vinayshanbhag/10Hz-100KHz-LNA/README.md

# 10Hz-100KHz-LNA
Low noise amplifier for ripple and noise measurements (10Hz-100Khz)
based on <a href="https://github.com/vinayshanbhag/10Hz-100KHz-LNA/blob/main/an-83.pdf">AN-83</a>

### Schematic


### Impulse response (spice model)
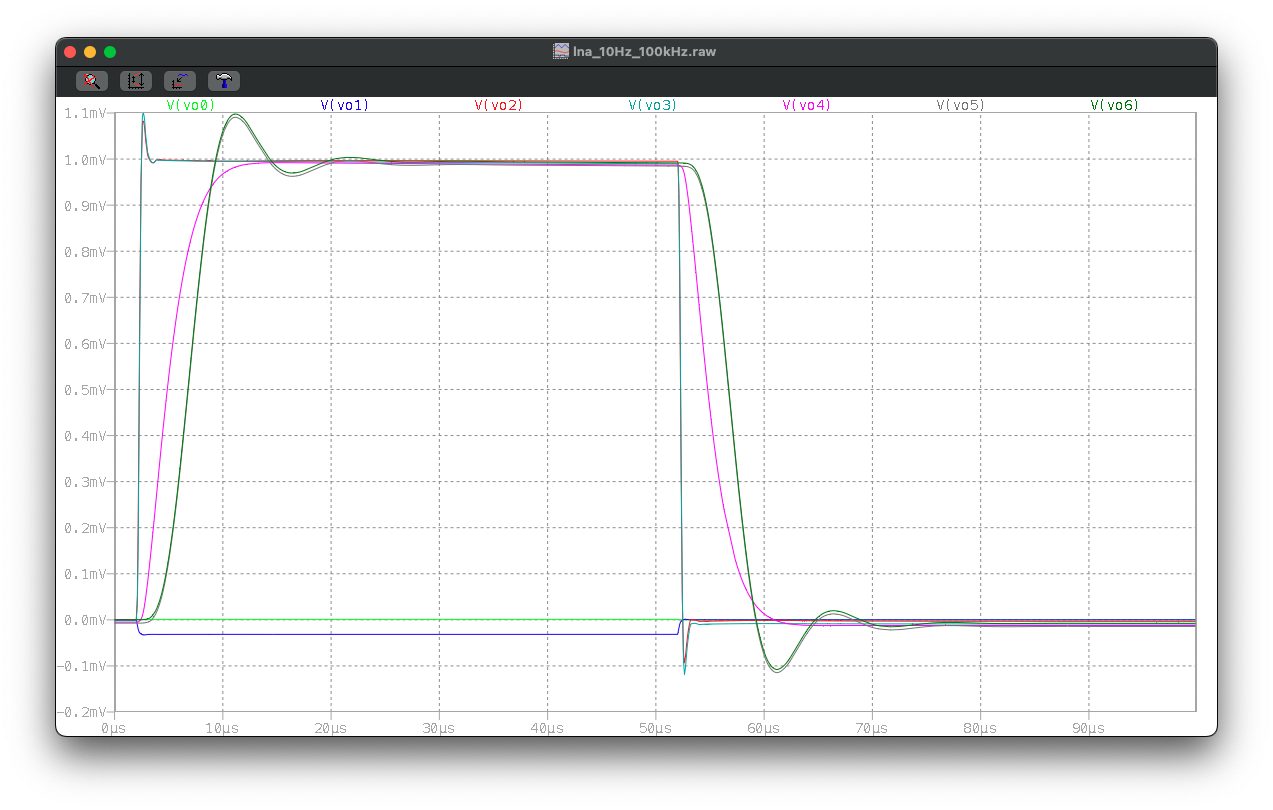
[picture p1: impulse-response-spice.png]


### Frequency response (spice model)
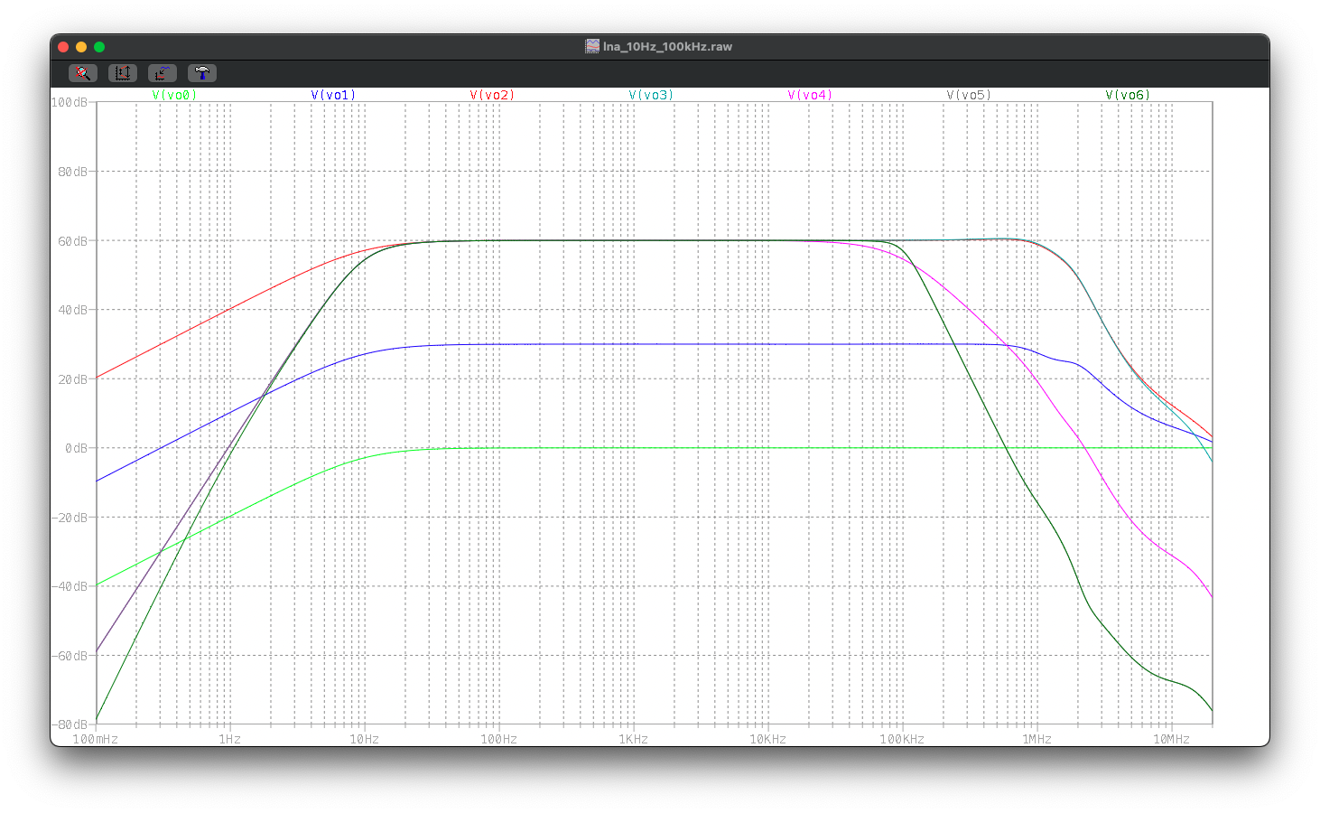
[picture p2: freq-response-spice.png]


### Frequency response (measured)
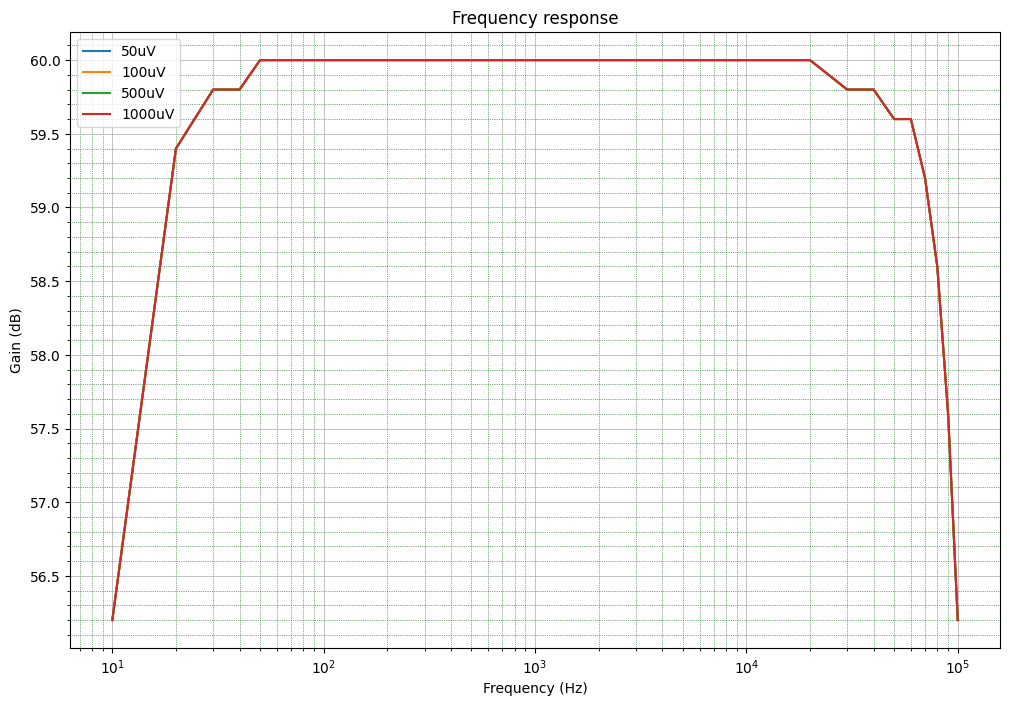
[picture p3: freq-response-measured.png]


### Input referred noise (spice model)
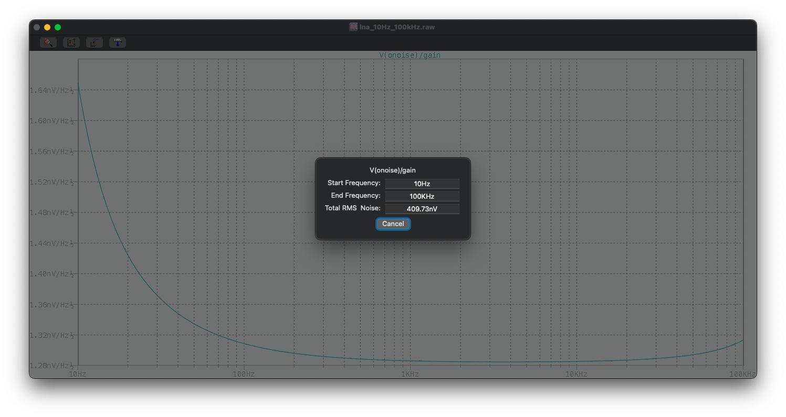
[picture p4: input-referred-noise-spice.png]


### Input referred noise (measured)
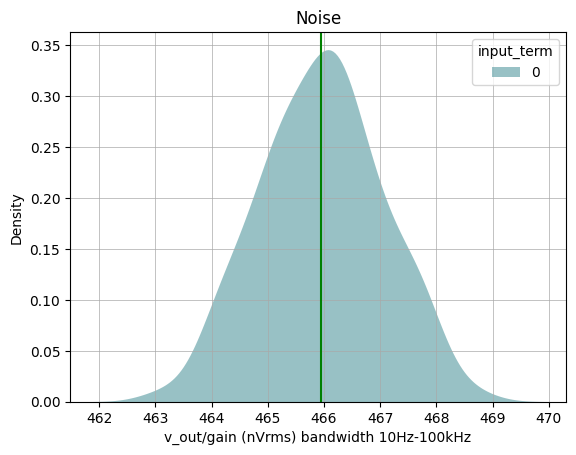
[picture p5: noise_short.png]


| Power Supply | Noise spec | Measured (HP34401A) |
|---|---|---|
| HP6114A | 40uVrms at any line voltage and under any load condition within rating | 48uVrms @25V |
| HP33120A | NA | 72uVrms @10V DC out |
| HP6203B | <200uVrms  | 128uVrms  @5V |
| TPS4000 | <0.5mVrms  | 0.1mVrms  @20V |
