vinayshanbhag/10Hz-100KHz-LNA/3d.png

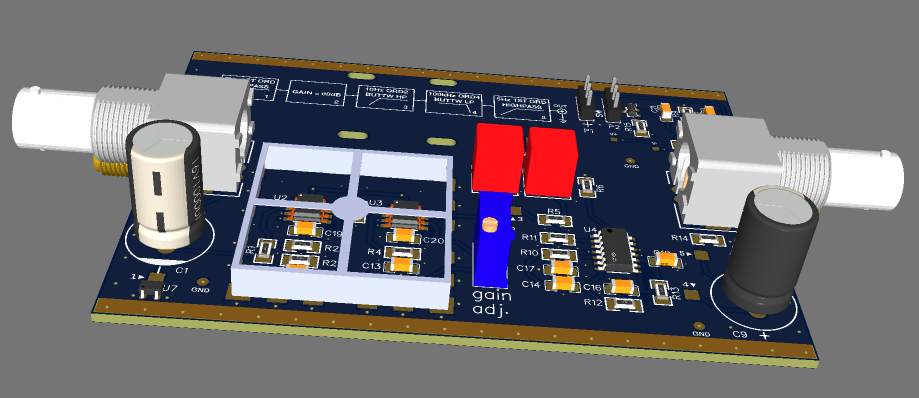
3d.png
