vinayshanbhag/10Hz-100KHz-LNA/HP6114A_25V.png

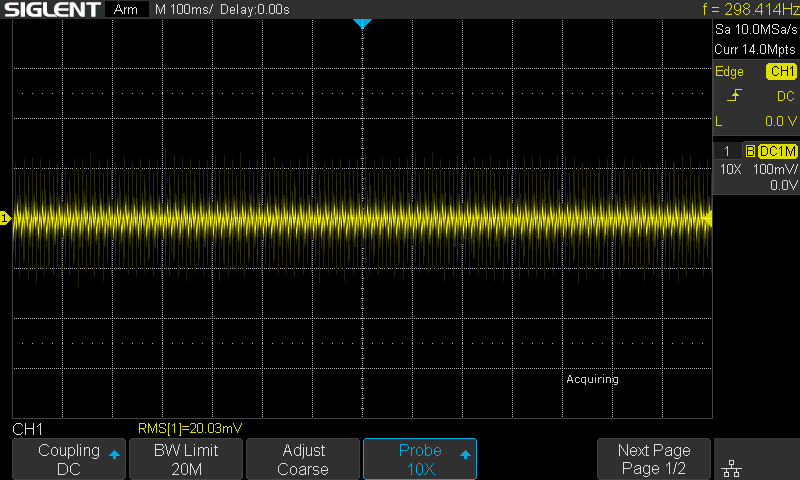
HP6114A_25V.png
