vinayshanbhag/10Hz-100KHz-LNA/HP6203B_5V.png

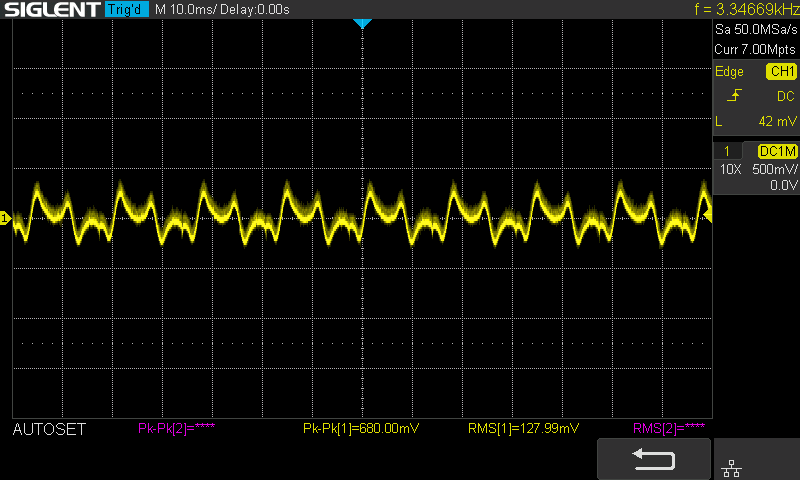
HP6203B_5V.png
