vinayshanbhag/10Hz-100KHz-LNA/HP33120A_10V.png

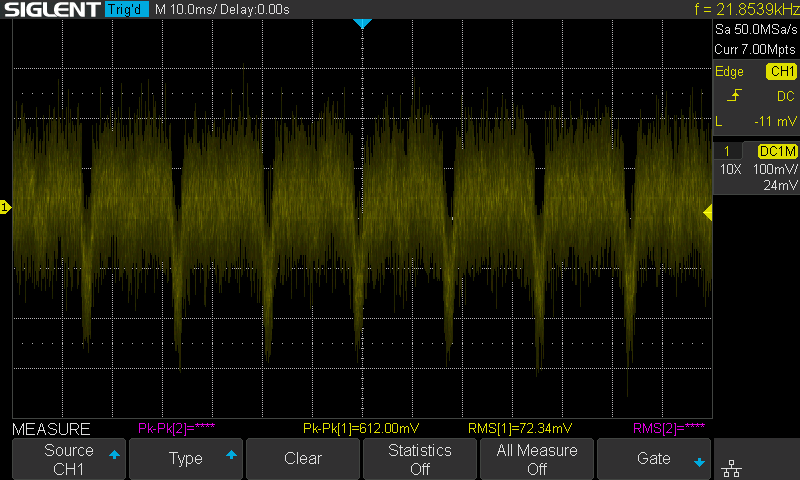
HP33120A_10V.png
