vinayshanbhag/10Hz-100KHz-LNA/noise_50.png

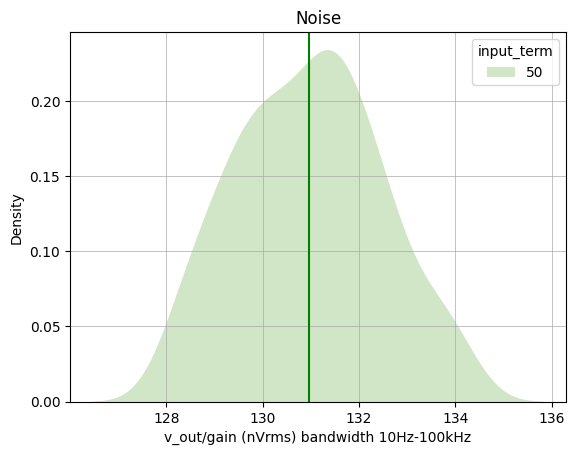
noise_50.png
