vinayshanbhag/10Hz-100KHz-LNA/noise_open.png

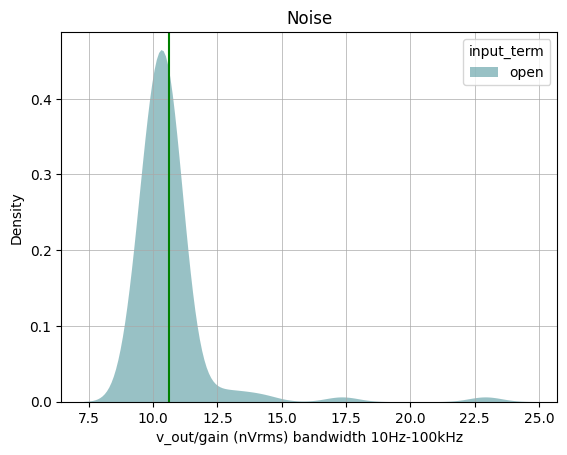
noise_open.png
