vinayshanbhag/10Hz-100KHz-LNA/lna-bom.csv

ID | Name | Designator | Quantity | Manufacturer Part | Manufacturer | Supplier | Supplier Part
1 | 330u | C1,C9 | 2 | EGXF101ELL331MK35S | Chemi-Con | DigiKey | 565-4542-ND
2 | 4.7u | C2,C3 | 2 | MKS2B044701K00KSSD | WIMA | DigiKey | 1928-MKS2B044701K00KSSD-ND
3 | 0.1u | C5,C6,C7,C8,C10,C11,C12,C15 | 8 | GMC31CG104J50NT | Cal-Chip Electronics, Inc. | DigiKey | 4713-GMC31CG104J50NTCT-ND
4 | 120p | C14 | 1 | C1206C121J1GACTU | KEMET | DigiKey | 399-C1206C121J1GACTUCT-ND
5 | 680p | C16 | 1 | C1206C681J5GACTU | KEMET | DigiKey | 399-C1206C681J5GACTUCT-ND
6 | 100p | C17,C18 | 2 | C1206C101J1GACTU | KEMET | DigiKey | 399-C1206C101J1GACTUCT-ND
7 | SL3401S | Q1 | 1 | SL3401S | Shenzhen Slkormicro Semicon Co., Ltd. | DigiKey | 5399-SL3401STR-ND
8 | 49.9 | R1,R9 | 2 | RT1206FRE0749R9L | YAGEO | DigiKey | 13-RT1206FRE0749R9LCT-ND
9 | 3.16k | R2,R2' | 2 | RT1206FRE073K16L | YAGEO | DigiKey | 13-RT1206FRE073K16LCT-ND
10 | 100 | R3 | 1 | RC1206FR-07100RL | YAGEO | DigiKey | 311-100FRCT-ND
11 | 5.9k | R4,R15 | 2 | RT1206FRE075K9L | YAGEO | DigiKey | 13-RT1206FRE075K9LCT-ND
12 | 6.19k | R4' | 1 | RT1206FRE076K19L | YAGEO | DigiKey | 13-RT1206FRE076K19LCT-ND
13 | 2.49k | R5 | 1 | RC1206FR-072K49L | YAGEO | DigiKey | 311-2.49KFRCT-ND
14 | 4.99k | R6 | 1 | RC1206FR-074K99L | YAGEO | DigiKey | 311-4.99KFRCT-ND
15 | 100k | R7,R8 | 2 | RT1206FRD07100KL | YAGEO | DigiKey | 13-RT1206FRD07100KLCT-ND
16 | 17.4K | R10 | 1 | RC1206FR-0717K4L | YAGEO | DigiKey | 311-17.4KFRCT-ND
17 | 12.1K | R11 | 1 | RC1206FR-0712K1L | YAGEO | DigiKey | 311-12.1KFRCT-ND
18 | 4.75K | R12 | 1 | RC1206FR-074K75L | YAGEO | DigiKey | 311-4.75KFRCT-ND
19 | 7.5K | R13 | 1 | RC1206FR-077K5L | YAGEO | DigiKey | 311-7.50KFRCT-ND
20 | 510 | R14 | 1 | RT1206FRE07510RL | YAGEO | DigiKey | 13-RT1206FRE07510RLCT-ND
21 | 2K | RP3 | 1 | 3296W-1-202LF | Bourns Inc. | DigiKey | 3296W-202LF-ND
22 | BNC | U1,U5 | 2 | CONBNC002 | TE Connectivity Linx | DigiKey | 343-CONBNC002-ND
23 | LT1028CS8#PBF | U2,U3 | 2 | LT1028CS8#PBF | Analog Devices Inc. | DigiKey | 505-LT1028CS8#PBF-ND
24 | LM321 | U6 | 1 | LM321 | Shenzhen Slkormicro Semicon Co., Ltd. | DigiKey | 5399-LM321CT-ND
25 | BAV199Q-7-F | U7 | 1 | BAV199Q-7-F | Diodes Incorporated | DigiKey | BAV199Q-7-FDITR-ND
26 | 36103305 | U12 | 1 | 36103305 | Würth Elektronik | DigiKey | 732-2492-ND
27 | OPA4189IDT | U4 | 1 | OPA4189IDT | Texas Instruments | DigiKey | 296-OPA4189IDTCT-ND
