vinayshanbhag/10Hz-100KHz-LNA/lna-schematic.pdf

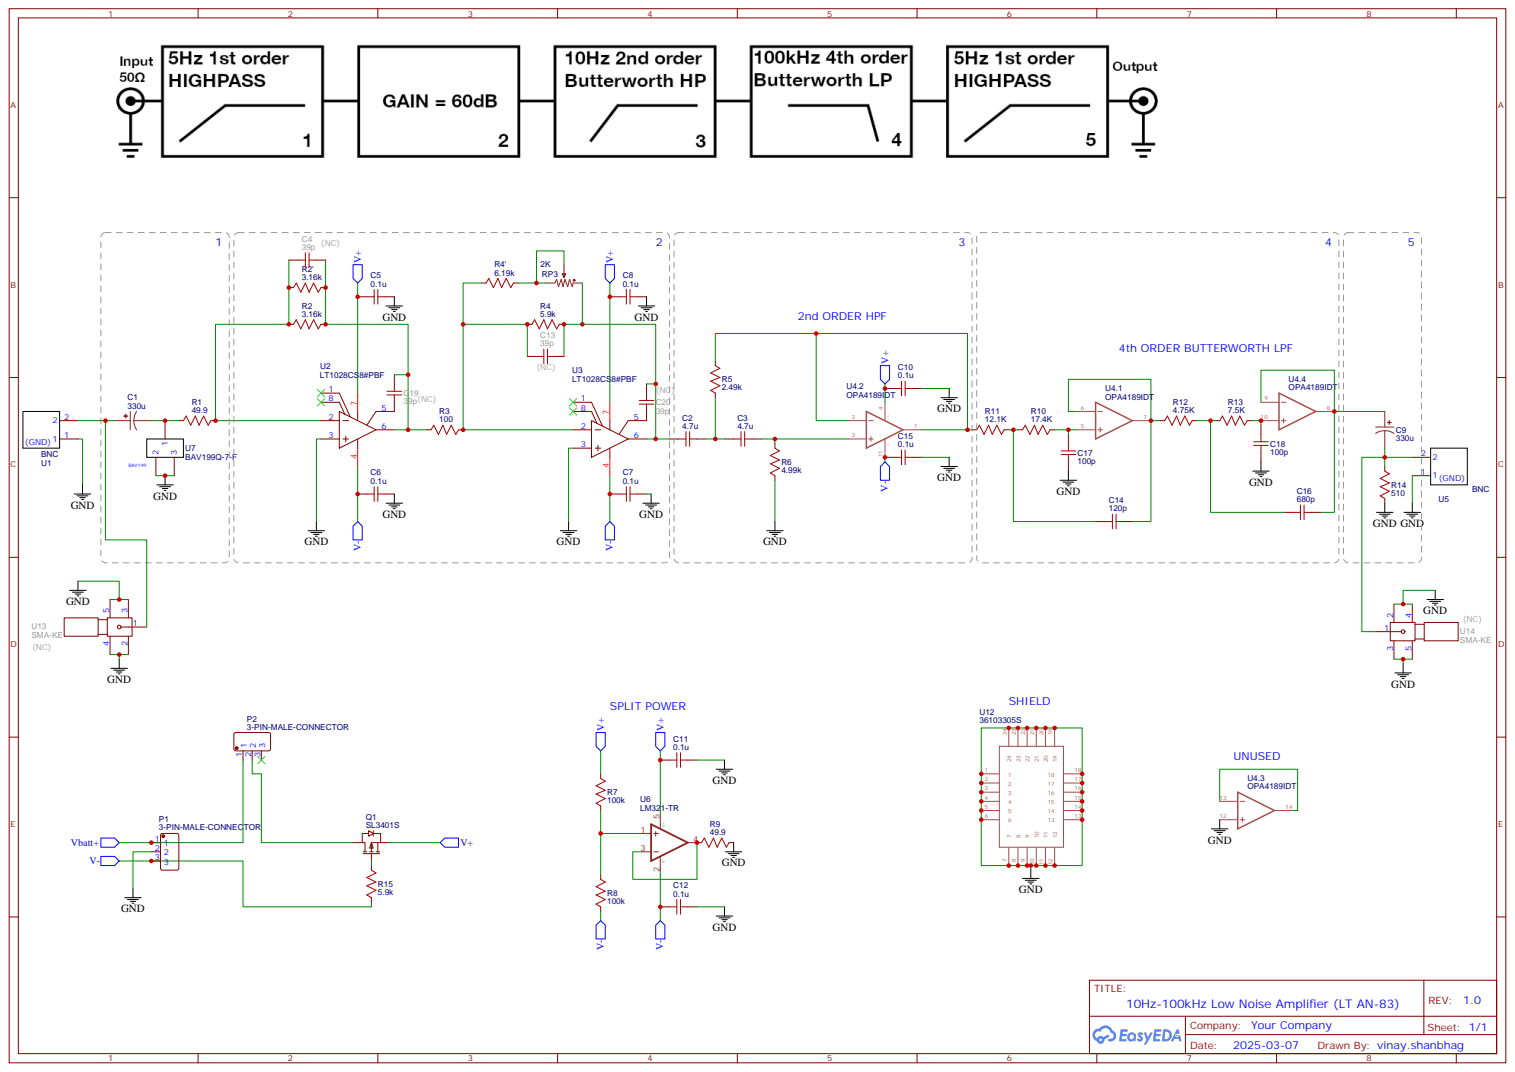
[picture p12: page 1]

Drawn By: vinay.shanbhag
