vinayshanbhag/10Hz-100KHz-LNA/lna_measurements.csv

freq | freq_units | v_in | v_in_units | shape | v_out | v_out_units | voltage_gain | gain_db
1 | Hz | 51.15 | uVrms | sinusoid | 2.292408 | mVrms | 44.81736070381231 | 33.0
2 | Hz | 51.15 | uVrms | sinusoid | 2.366453 | mVrms | 46.26496578690127 | 33.4
3 | Hz | 51.15 | uVrms | sinusoid | 3.215876 | mVrms | 62.87147605083089 | 36.0
4 | Hz | 51.15 | uVrms | sinusoid | 5.574092 | mVrms | 108.97540566959923 | 40.8
5 | Hz | 51.15 | uVrms | sinusoid | 9.252674 | mVrms | 180.89294232649073 | 45.199999999999996
6 | Hz | 51.15 | uVrms | sinusoid | 13.878567 | mVrms | 271.3307331378299 | 48.6
7 | Hz | 51.15 | uVrms | sinusoid | 18.967419 | mVrms | 370.81953079178885 | 51.4
8 | Hz | 51.15 | uVrms | sinusoid | 24.056123 | mVrms | 470.3054349951124 | 53.4
9 | Hz | 51.15 | uVrms | sinusoid | 28.726177 | mVrms | 561.6065884652982 | 55.0
10 | Hz | 51.15 | uVrms | sinusoid | 32.76495 | mVrms | 640.565982404692 | 56.2
20 | Hz | 51.15 | uVrms | sinusoid | 47.584134 | mVrms | 930.2860997067448 | 59.400000000000006
30 | Hz | 51.15 | uVrms | sinusoid | 49.685496 | mVrms | 971.3684457478006 | 59.800000000000004
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
